mart2549/loxone-kinder-musikbox/bilder/Musikbox_Foto_2.jpg

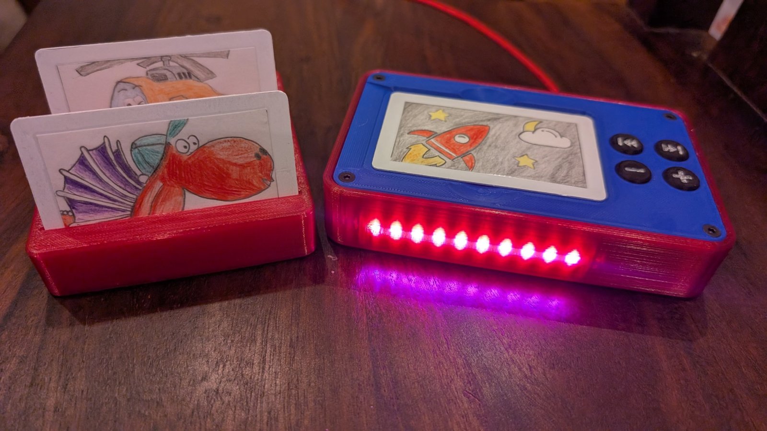
bilder/Musikbox_Foto_2.jpg
