mart2549/loxone-kinder-musikbox/3d-druck/kartenstaender.stl

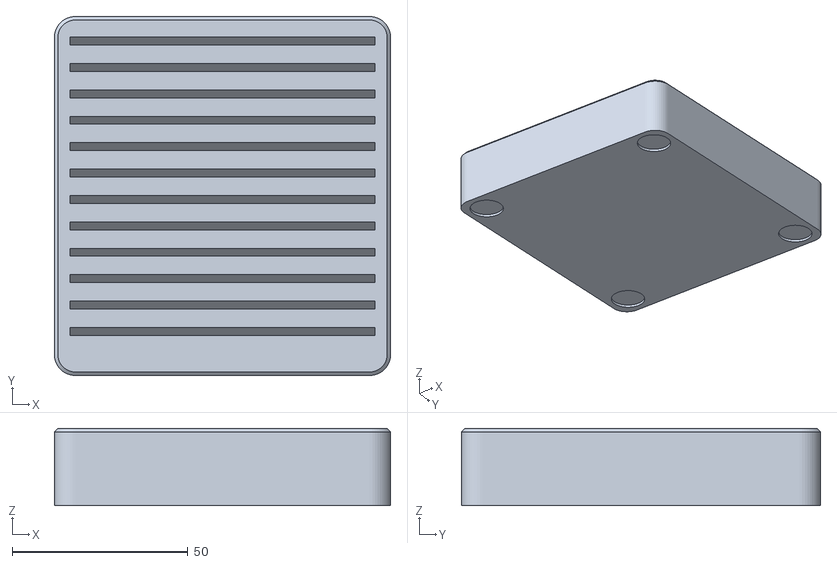
[picture p8: CAD file, 2026-10-12]
3d-druck/kartenstaender.stl
95.6 x 102.0 x 22.0
