mart2549/loxone-kinder-musikbox/3d-druck/deckel.stl

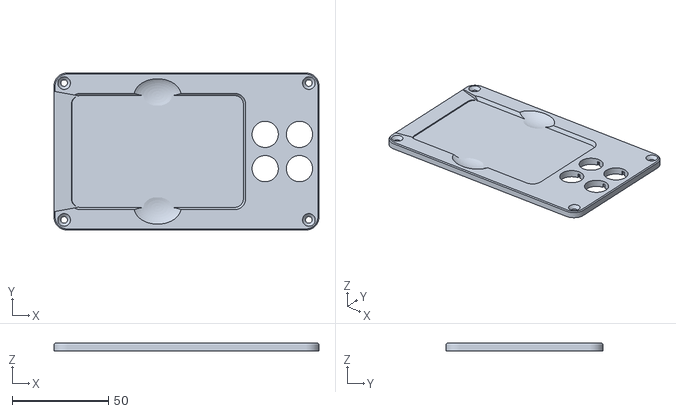
[picture p9: CAD file, 2026-10-12]
3d-druck/deckel.stl
137.5 x 81.5 x 4.00
