mart2549/loxone-kinder-musikbox/3d-druck/unterteil_fenster_offen.stl

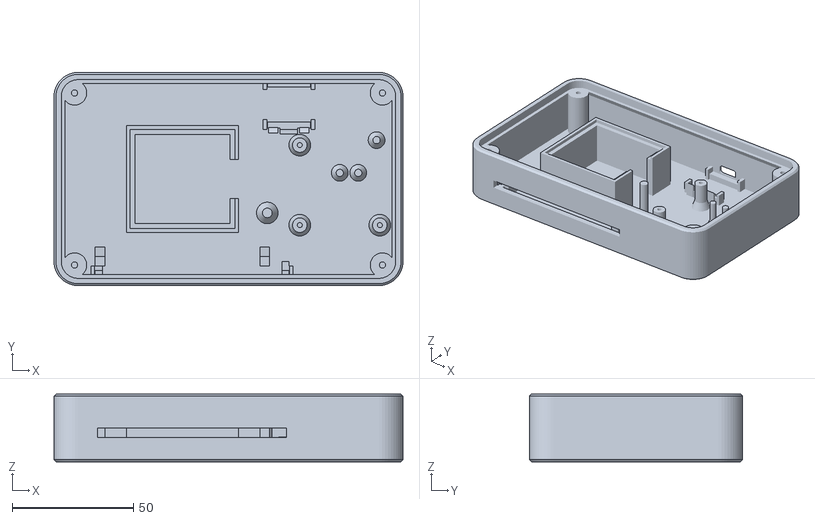
[picture p10: CAD file, 2026-10-12]
3d-druck/unterteil_fenster_offen.stl
144.0 x 88.0 x 28.0
