mart2549/loxone-kinder-musikbox/3d-druck/lichtleiste_duenn.stl

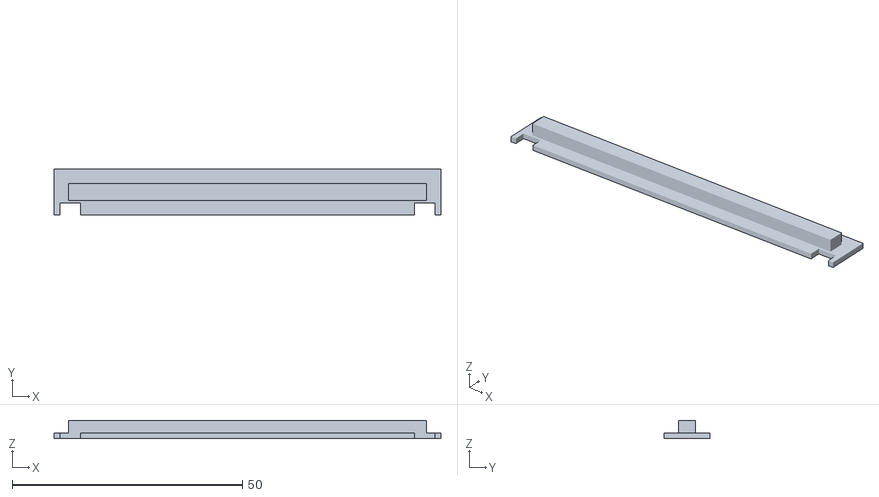
[picture p11: CAD file, 2026-10-12]
3d-druck/lichtleiste_duenn.stl
84.0 x 10.0 x 4.00
