mart2549/loxone-kinder-musikbox/3d-druck/lichtleiste_dummy_rahmen.stl

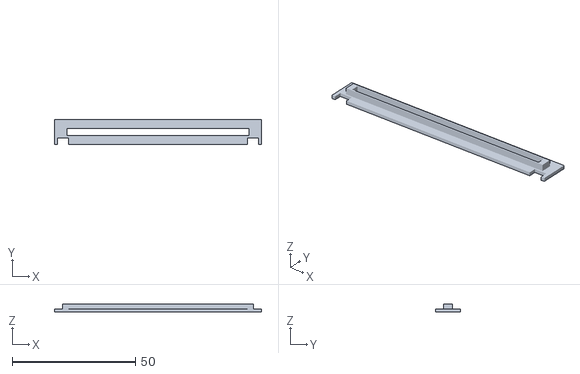
[picture p12: CAD file, 2026-10-12]
3d-druck/lichtleiste_dummy_rahmen.stl
84.0 x 10.0 x 3.40
