mart2549/loxone-kinder-musikbox/3d-druck/tastkappen.stl

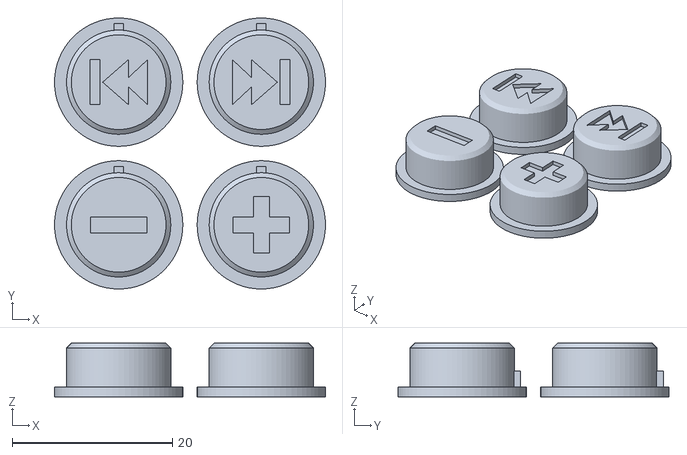
[picture p13: CAD file, 2026-10-12]
3d-druck/tastkappen.stl
33.8 x 33.8 x 6.70
