mart2549/loxone-kinder-musikbox/3d-druck/lichtleiste.stl

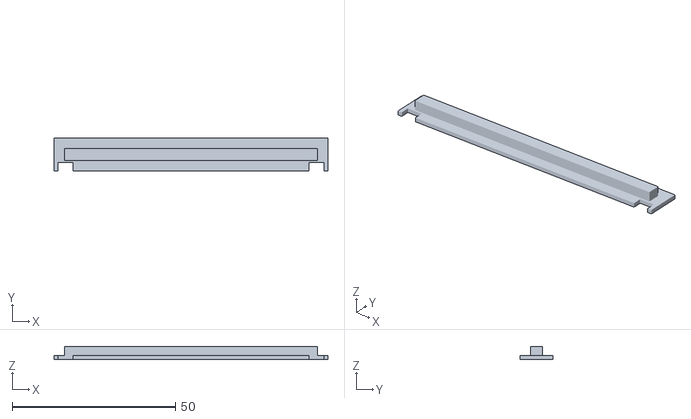
[picture p14: CAD file, 2026-10-12]
3d-druck/lichtleiste.stl
84.0 x 10.0 x 4.00
