mart2549/loxone-kinder-musikbox/(list of files, cad)

Other CAD files:
3d-druck/unterteil_fenster_zu.stl
